tfabien/smc-pad-sensitivity-mod/files/SMC-Pad_spacers_full_sheet.stl

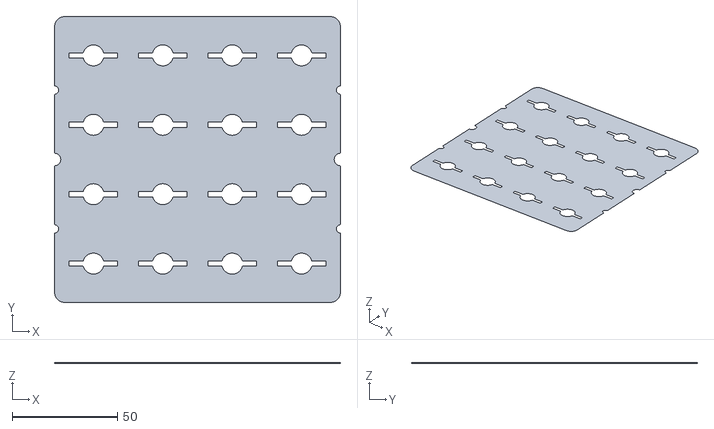
[picture p17: CAD file, 2026-10-31]
files/SMC-Pad_spacers_full_sheet.stl
136.0 x 136.0 x 0.25
