tfabien/smc-pad-sensitivity-mod/files/SMC-Pad_spacers_3Dprint.3mf

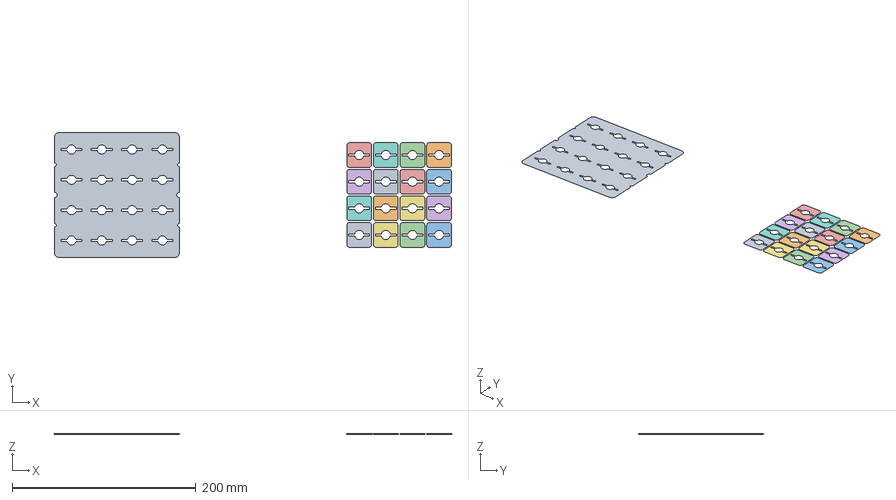
[picture p18: CAD file, 2026-10-31]
files/SMC-Pad_spacers_3Dprint.3mf
432.2 x 136.0 x 0.25 mm
Body2.stl
SMC-Pad_spacer_single.stl x 16
