tfabien/smc-pad-sensitivity-mod/files/SMC-Pad_spacer_single.stl

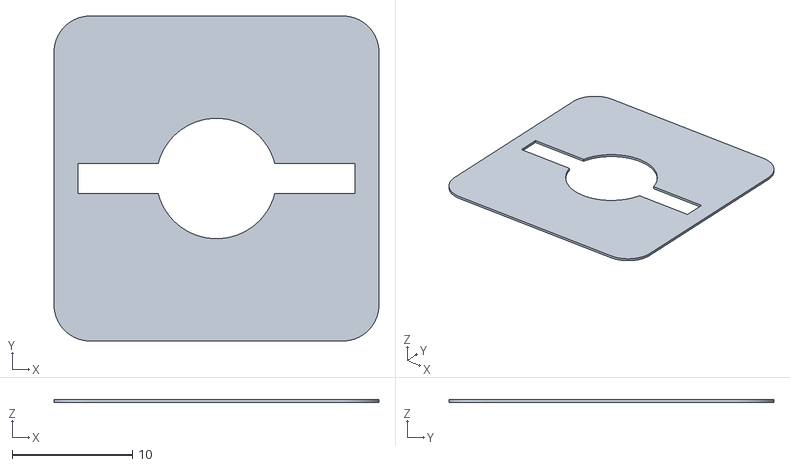
[picture p19: CAD file, 2026-10-31]
files/SMC-Pad_spacer_single.stl
27.0 x 27.0 x 0.25
