tfabien/smc-pad-sensitivity-mod/files/SMC-Pad_spacers_sheet_4x4.dxf

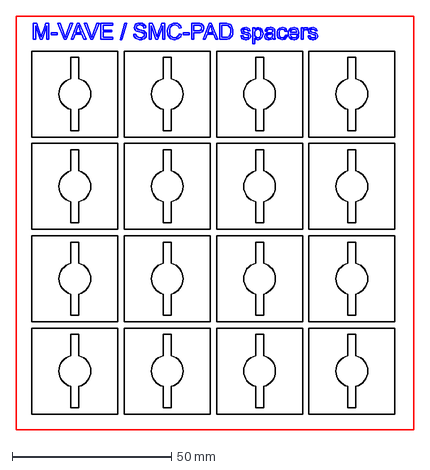
[picture p20: CAD file, 2026-10-31]
files/SMC-Pad_spacers_sheet_4x4.dxf
125.0 x 130.0 mm
