tfabien/smc-pad-sensitivity-mod/(list of files, cad)

Other CAD files:
files/SMC-Pad_spacer_single.dxf
files/SMC-Pad_spacers_full_sheet.dxf
