tfabien/smc-pad-sensitivity-mod/(commit log)

2026-10-31 Update guide: 9 case screws, battery first, loose sheet orientation, MidiSuite links
2026-10-31 README: tip to stack two spacer layers for more sensitivity
2026-10-31 README: laser-cut vinyl tested, 3D-printed spacers not tested
2026-10-31 Rework guide: vertical-slot spacers, full sheet stuck on the transparent sheet
    Claude-Session: https://claude.ai/code/session_015ngzumRVhKgTpj7vppR9fs
    [SMC-Pad_spacer_single.dxf, SMC-Pad_spacers_3Dprint.3mf, SMC-Pad_spacers_full_sheet.dxf, SMC-Pad_spacers_sheet_4x4.dxf]
2026-10-31 Add STL files, update 3MF to the new spacer design, update README
    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
    [SMC-Pad_spacer_single.stl, SMC-Pad_spacers_3Dprint.3mf, SMC-Pad_spacers_full_sheet.stl]
2026-10-31 Step 5: keep a single photo, relabel PCB + sheet with black pads
    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
2026-10-31 Step 5 photo labels (PCB + pads sheet / Silicone pads), drop book-page wording
    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
2026-11-02 Recommend electrical tape (best result), laser/3D files marked experimental; update photos and video
    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
2026-11-02 Warning at the top, PH00 screwdriver, video: S M C pad pronunciation and early warning
    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
2026-11-02 Merge steps 8-9: test hits and calibrate in MidiSuite; faster voice-over
    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
